imaimai17468/keyboard/scripts/assembly_viewer.html

# macjis 完成図

案 C · 81 キー · Choc V1 · 基板 v0（KiCad データ）· ケースは仮

完成 分解 基板

斜め 真上 横 奥

表 裏

ラベル

読み込み中…

## 表示する部品

ケース カバー キーキャップ スイッチ 基板 電池

「分解」で部品を上下に離して重なりを確認できます。「基板」は KiCad の設計データそのままの基板で、表と裏を切り替えられます。

## 仕上げ（確定）

キーキャップ

黒（Black Resin）、刻印は彫りのみ

基板

黒（JLCPCB のソルダーレジスト）

ケース

アルミ、ビーズブラスト + クリアアルマイト（銀）

上帯カバー

黒（Black Resin、キーキャップと同じ）、厚さ 2 mm

## 寸法

ケース外形

294.8 × 143.3 mm

ケース高さ

キー側 15.1 mm／上帯側 18.1 mm

キートップまで

16.1 mm（キー側）

基板

287.75 × 136.3 × 1.6 mm

キーキャップ

18.0 mm 角 × 5.8 mm

キーの沈み

2.7 mm

## 部品の数

スイッチ

85（81 キー）

ホットスワップソケット

85

ダイオード

81

M2 × 3 ナベ頭ネジ（基板）

7

M2 × 10 ネジ（カバー、底から）

3 ＋ インサート 3

中央の支え

3（上にカプトンテープ）

電源スイッチ

なし（fn＋esc 長押しで切る）

マイコン

XIAO nRF52840 Plus

電池

LiPo 250 mAh（EEMB 502030）

## まだ決まっていないこと

- なし（キーキャップの軸の太さは試作で 1.25 mm に決定）

## 購入リスト

2026-11-02 に全部注文済み。価格は 2026-10-20 の見積もり（実際の支払額は各店の注文履歴）。JLC は 1 回の注文が 50 件までなので 2 回に分けた

### JLC で作るもの

#### JLC3DP¥15,554

- キーキャップ 1u × 75（Black Resin） (https://jlc3dp.com/3d-printing-quote)¥12,8211 個 ¥171。軸 1.25 mm（試作で決定）。F・J は天板にポッチ付き 注文済み
- キーキャップ 大きいキー × 6 (https://jlc3dp.com/3d-printing-quote)¥1,065tab ¥173、control・右 shift ¥174、左 shift ¥177、return ¥179、space ¥188 注文済み
- 上帯カバー（Black Resin、厚さ 2 mm） (https://jlc3dp.com/3d-printing-quote)¥524長さ 290 mm 注文済み
- 送料（OCS Express、0.27 kg）¥1,1444〜6 営業日

#### JLCPCB$34.71 ≈ ¥5,311

- 基板 × 5 枚（2 層・1.6 mm・黒・鉛フリー HASL） (https://cart.jlcpcb.com/quote)$24.90287.75 × 136.3 mm。製造 3 日 注文済み
- 送料（UPS、0.81 kg）$9.812〜4 営業日

#### JLCCNC$126.22 ≈ ¥19,312

- アルミケース（6061、ビーズブラスト + アルマイト Natural・マット） (https://jlccnc.com/cnc-machining-quote)$116.41ネジ穴と底の段を直したデータで取り直した金額。最終価格は JLC の審査後に確定
- 送料（UPS、0.58 kg）$9.812〜4 営業日。M2 めねじ 7 か所は図面（case_drawing.pdf）、奥の面のアイコンと @imaimai17468 のレーザー刻印は DXF（case_marking.dxf、JLCCNC は DWG/DXF 必須）と図面 case_marking_drawing.pdf で指定。追加費用は審査で決まる 注文済み

### 電子部品

#### 遊舎工房¥12,683 + 送料

- Seeed Studio XIAO nRF52840 Plus (https://shop.yushakobo.jp/products/10946)¥2,200 × 1無線マイコン。予備が欲しければもう 1 個（壊したときの作り直しが早い） 購入済み
- Kailh Ambients Silent Choc V1 Nocturnal 20g（35 個入り） (https://shop.yushakobo.jp/collections/choc-v1/products/ambients-silent-choc-switches-20g-linear-nocturnal)¥5,390 × 2スイッチ 85 個 + 予備。試作用に買った 1 袋と合わせて 105 個 注文済み
- Kailh Switch Socket（10 個入り） (https://shop.yushakobo.jp/products/a01ps)¥187 × 9ホットスワップソケット 85 個 + 予備。種類は「Choc（CPG135001S30）」を選ぶ 注文済み
- ダイオード - SMDタイプ（100 個入り） (https://shop.yushakobo.jp/products/a0800di-02-100)¥2201N4148W × 81。手ではんだ付け 注文済み

#### Amazon¥1,199

- EEMB 3.7V 502030 250mAh リポバッテリー (https://www.amazon.co.jp/dp/B08FD3V6TF)¥1,199電池。コネクタは切って線を基板の穴に直接はんだ付け（赤 = 1 番ピン +） 注文済み

### ネジ・組み立て部品

#### Amazon¥4,995

- ステンレス/SSブラック ナベ小ねじ M2×3（10 本） (https://www.amazon.co.jp/dp/B0B2ZM6G8H)¥680基板をケースに留める × 7。黒いネジで基板・キーキャップの黒になじむ。めねじは有効 1.5 mm なので 3 mm（基板 1.6 + 1.4） 注文済み
- ステンレス ナベ頭 小ねじ M2×10（10 本） (https://www.amazon.co.jp/dp/B079WL3BDD)¥600底から上帯カバーを留める × 3 注文済み
- uxcell インサートナット M2 3×3 mm（100 個） (https://www.amazon.co.jp/dp/B0CTTLJL6S)¥852カバーの柱 × 3。樹脂のカバーは熱で溶けないので接着で入れる 注文済み
- セメダイン ハイスーパー5（6 g） (https://www.amazon.co.jp/dp/B003SJVNQ0)¥427インサートの接着用（5 分硬化エポキシ） 注文済み
- ゴム足 φ10 × 高さ 4 mm（16 個） (https://www.amazon.co.jp/dp/B07V8RDJTH)¥598手前の足 × 2 注文済み
- 3M クッションゴム CS-01 φ7.9 × 2.2 mm（22 粒） (https://www.amazon.co.jp/dp/B00V5MQQ5A)¥344奥の足 × 2。奥が 1.2 mm 高くなり、手前に少し傾く 注文済み
- DanYun カプトンテープ 15 mm × 33 m (https://www.amazon.co.jp/dp/B08JYBJ43B)¥645電池の下の絶縁と、中央の支え柱の上に貼る 注文済み
- 3M スコッチ 強力両面テープ 15 mm × 10 m（PSD-15R） (https://www.amazon.co.jp/dp/B09V358S45)¥849電池をケースの底に貼る 注文済み

### 合計（2026-10-20 の見積もり）

JLC（3 社、送料込み）

¥40,177

遊舎工房（送料込み）

¥18,623

Amazon

¥6,194

合計

¥64,994

ドルは 1 ドル ≈ 153 円（JLC3DP の円表示から逆算）で換算。購入済みの XIAO（¥2,200）は含まない。JLC の荷物は輸入の消費税と通関手数料が別にかかることがある（数千円程度）。JLC の画面に出ているクーポン（$20〜$50 引き）が使えればその分安くなる。
