imaimai17468/keyboard/pcb/macjis.kicad_pcb

## KiCad design pcb/macjis.kicad_pcb (2026-10-20)

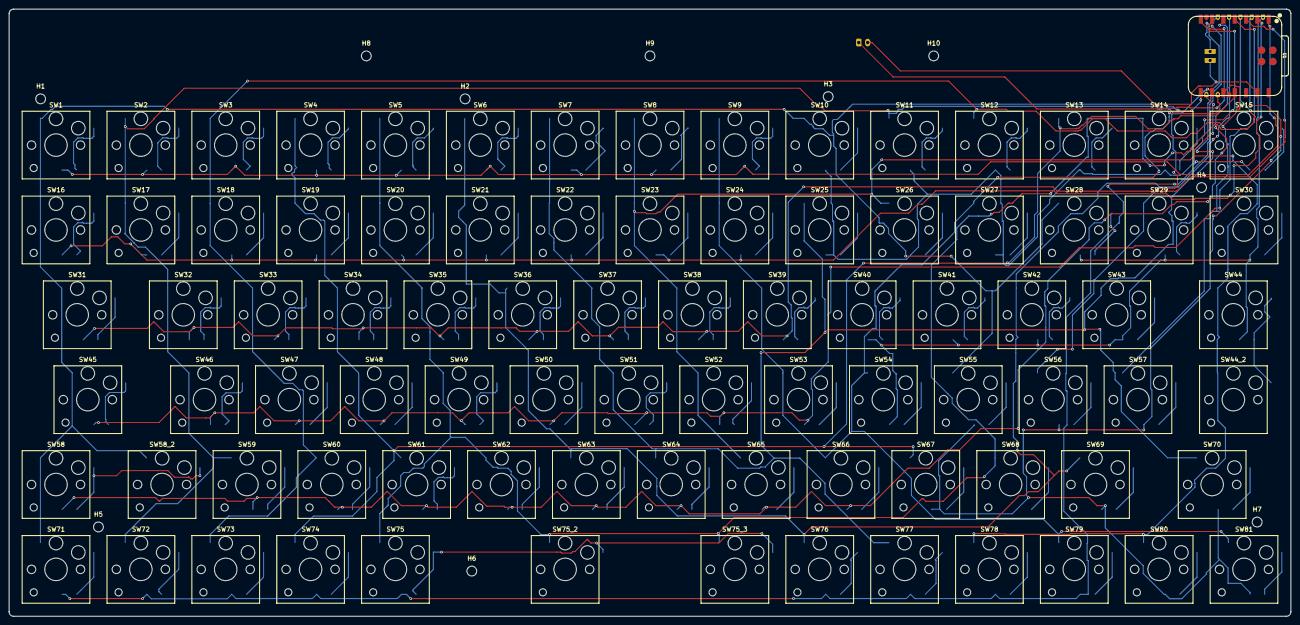
[picture p1: board macjis.kicad_pcb from above]

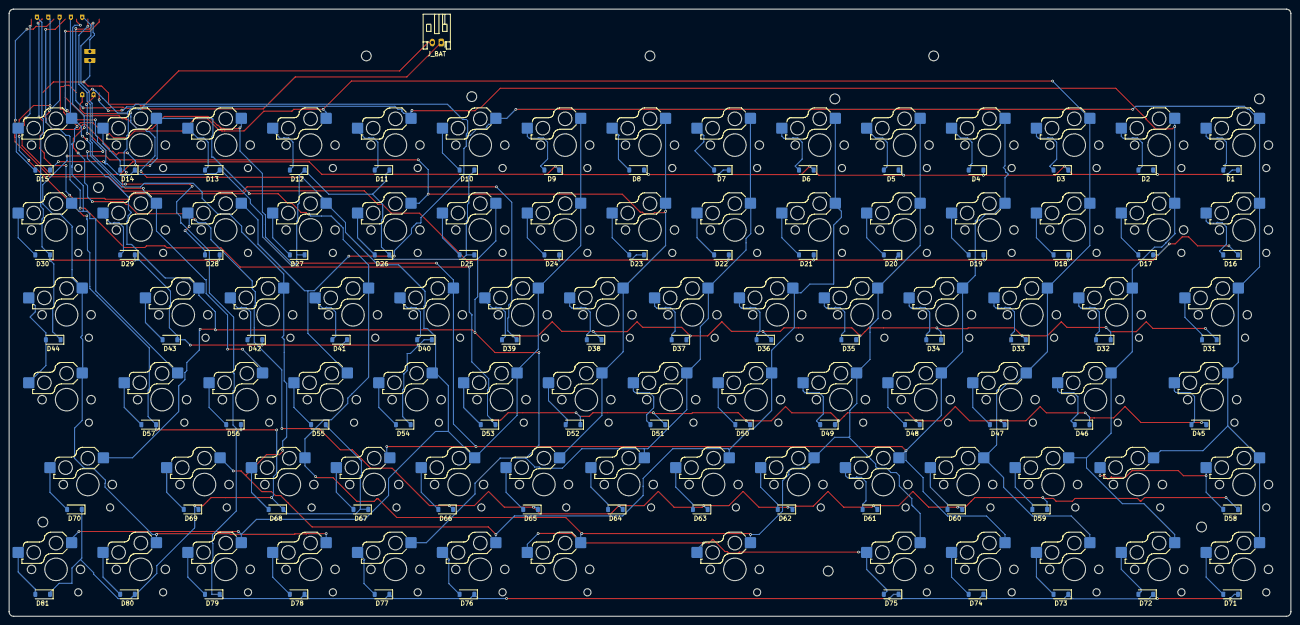
[picture p2: board macjis.kicad_pcb from below]

Board: 2 copper layers, 287.8 x 136.3 mm, 178 parts (82 on the bottom side), 101 nets.

Parts:
D1, D2, D3, D4, D5, D6, D7, D8, D9, D10, D11, D12, D13, D14, D15, D16, D17, D18, D19, D20, D21, D22, D23, D24, D25, D26, D27, D28, D29, D30, D31, D32, D33, D34, D35, D36, D37, D38, D39, D40, D41, D42, D43, D44, D45, D46, D47, D48, D49, D50, D51, D52, D53, D54, D55, D56, D57, D58, D59, D60, D61, D62, D63, D64, D65, D66, D67, D68, D69, D70, D71, D72, D73, D74, D75, D76, D77, D78, D79, D80, D81: D_SOD-123
H1, H2, H3, H4, H5, H6, H7, H8, H9, H10: MountingHole_2.2mm_M2_ISO14580
J_BAT: JST_PH_S2B-PH-K_1x02_P2.00mm_Horizontal
SW1, SW2, SW3, SW4, SW5, SW6, SW7, SW8, SW9, SW10, SW11, SW12, SW13, SW14, SW15, SW16, SW17, SW18, SW19, SW20, SW21, SW22, SW23, SW24, SW25, SW26, SW27, SW28, SW29, SW30, SW31, SW32, SW33, SW34, SW35, SW36, SW37, SW38, SW39, SW40, SW41, SW42, SW43, SW44, SW44_2, SW45, SW46, SW47, SW48, SW49, SW50, SW51, SW52, SW53, SW54, SW55, SW56, SW57, SW58, SW58_2, SW59, SW60, SW61, SW62, SW63, SW64, SW65, SW66, SW67, SW68, SW69, SW70, SW71, SW72, SW73, SW74, SW75, SW75_2, SW75_3, SW76, SW77, SW78, SW79, SW80, SW81: SW_Hotswap_Kailh_Choc_V1V2
U1: XIAO-nRF52840-Plus-SMD

Connections:
BAT+: J_BAT.1, U1.28
COL0: SW1.1, SW10.1, SW16.1, SW28.1, SW31.1, SW45.1, SW55.1, SW58.1, SW58_2.1, SW71.1, U1.8
COL1: SW2.1, SW11.1, SW17.1, SW29.1, SW32.1, SW46.1, SW56.1, SW59.1, SW72.1, U1.9
COL2: SW3.1, SW12.1, SW18.1, SW30.1, SW33.1, SW47.1, SW57.1, SW60.1, SW73.1, U1.10
COL3: SW4.1, SW13.1, SW19.1, SW34.1, SW40.1, SW48.1, SW61.1, SW67.1, SW74.1, U1.11
COL4: SW5.1, SW14.1, SW20.1, SW35.1, SW41.1, SW49.1, SW62.1, SW68.1, SW75.1, SW75_2.1, SW75_3.1, U1.17
COL5: SW6.1, SW15.1, SW21.1, SW36.1, SW42.1, SW50.1, SW63.1, SW69.1, SW76.1, U1.18
COL6: SW7.1, SW22.1, SW25.1, SW37.1, SW43.1, SW51.1, SW64.1, SW70.1, SW77.1, U1.19
COL7: SW8.1, SW23.1, SW26.1, SW38.1, SW44.1, SW44_2.1, SW52.1, SW65.1, SW78.1, SW80.1, U1.21
COL8: SW9.1, SW24.1, SW27.1, SW39.1, SW53.1, SW54.1, SW66.1, SW79.1, SW81.1, U1.22
GND: J_BAT.2, U1.13, U1.29
ROW0: D1.1, D2.1, D3.1, D4.1, D5.1, D6.1, D7.1, D8.1, D9.1, U1.1
ROW1: D16.1, D17.1, D18.1, D19.1, D20.1, D21.1, D22.1, D23.1, D24.1, U1.2
ROW2: D31.1, D32.1, D33.1, D34.1, D35.1, D36.1, D37.1, D38.1, D39.1, U1.3
ROW3: D45.1, D46.1, D47.1, D48.1, D49.1, D50.1, D51.1, D52.1, D53.1, U1.4
ROW4: D58.1, D59.1, D60.1, D61.1, D62.1, D63.1, D64.1, D65.1, D66.1, U1.5
ROW5: D71.1, D72.1, D73.1, D74.1, D75.1, D76.1, D77.1, D78.1, D79.1, U1.6
ROW6: D10.1, D11.1, D12.1, D13.1, D14.1, D15.1, D25.1, D26.1, D27.1, U1.7
ROW7: D28.1, D29.1, D30.1, D40.1, D41.1, D42.1, D43.1, D44.1, D54.1, U1.15
ROW8: D55.1, D56.1, D57.1, D67.1, D68.1, D69.1, D70.1, D80.1, D81.1, U1.16
SW1_D: D1.2, SW1.2
SW2_D: D2.2, SW2.2
SW3_D: D3.2, SW3.2
SW4_D: D4.2, SW4.2
SW5_D: D5.2, SW5.2
SW6_D: D6.2, SW6.2
SW7_D: D7.2, SW7.2
SW8_D: D8.2, SW8.2
SW9_D: D9.2, SW9.2
SW10_D: D10.2, SW10.2
SW11_D: D11.2, SW11.2
SW12_D: D12.2, SW12.2
SW13_D: D13.2, SW13.2
SW14_D: D14.2, SW14.2
SW15_D: D15.2, SW15.2
SW16_D: D16.2, SW16.2
SW17_D: D17.2, SW17.2
SW18_D: D18.2, SW18.2
SW19_D: D19.2, SW19.2
SW20_D: D20.2, SW20.2
SW21_D: D21.2, SW21.2
SW22_D: D22.2, SW22.2
SW23_D: D23.2, SW23.2
SW24_D: D24.2, SW24.2
SW25_D: D25.2, SW25.2
SW26_D: D26.2, SW26.2
SW27_D: D27.2, SW27.2
SW28_D: D28.2, SW28.2
SW29_D: D29.2, SW29.2
SW30_D: D30.2, SW30.2
SW31_D: D31.2, SW31.2
SW32_D: D32.2, SW32.2
SW33_D: D33.2, SW33.2
SW34_D: D34.2, SW34.2
SW35_D: D35.2, SW35.2
SW36_D: D36.2, SW36.2
SW37_D: D37.2, SW37.2
SW38_D: D38.2, SW38.2
SW39_D: D39.2, SW39.2
SW40_D: D40.2, SW40.2
SW41_D: D41.2, SW41.2
SW42_D: D42.2, SW42.2
SW43_D: D43.2, SW43.2
SW44_D: D44.2, SW44.2, SW44_2.2
SW45_D: D45.2, SW45.2
SW46_D: D46.2, SW46.2
SW47_D: D47.2, SW47.2
SW48_D: D48.2, SW48.2
SW49_D: D49.2, SW49.2
SW50_D: D50.2, SW50.2
SW51_D: D51.2, SW51.2
SW52_D: D52.2, SW52.2
SW53_D: D53.2, SW53.2
SW54_D: D54.2, SW54.2
SW55_D: D55.2, SW55.2
SW56_D: D56.2, SW56.2
SW57_D: D57.2, SW57.2
SW58_D: D58.2, SW58.2, SW58_2.2
SW59_D: D59.2, SW59.2
SW60_D: D60.2, SW60.2
SW61_D: D61.2, SW61.2
SW62_D: D62.2, SW62.2
SW63_D: D63.2, SW63.2
SW64_D: D64.2, SW64.2
SW65_D: D65.2, SW65.2
SW66_D: D66.2, SW66.2
SW67_D: D67.2, SW67.2
SW68_D: D68.2, SW68.2
SW69_D: D69.2, SW69.2
SW70_D: D70.2, SW70.2
SW71_D: D71.2, SW71.2
SW72_D: D72.2, SW72.2
SW73_D: D73.2, SW73.2
SW74_D: D74.2, SW74.2
SW75_D: D75.2, SW75.2, SW75_2.2, SW75_3.2
SW76_D: D76.2, SW76.2
SW77_D: D77.2, SW77.2
SW78_D: D78.2, SW78.2
SW79_D: D79.2, SW79.2
SW80_D: D80.2, SW80.2
SW81_D: D81.2, SW81.2
