imaimai17468/keyboard/(commit log)

2026-10-19 Add parts spec for keycaps, PCB colors, and case
2026-10-19 Add keyboard design pipeline: layout, PCB, firmware, keycaps, case
    - Layout C (MacBook-style JIS, 81 keys) from KLE JSON to keys.json
    - 9x9 matrix on XIAO nRF52840 Plus, KiCad board generation and
    Freerouting autoroute with DRC and JLCPCB gerber export
    - Long keys supported by multiple parallel Choc V1 switches
    - ZMK v0.3 shield with soft off (fn+esc) and rgbled-widget status LED
    - build123d keycap prototypes and aluminium tray case with resin cover
    - 3D assembly viewer generated from the board and case models
    Claude-Session: https://claude.ai/code/session_01M64MEgyXCv4yyqteTiebrm
2026-10-20 Widen battery cavity for 20 mm wide LiPo; add hardware BOM
    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
2026-10-20 Update viewer BOM
    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
2026-10-20 Add purchase list with store links; match feet and inserts to buyable parts
    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
2026-10-20 Cover: Black Resin, 2 mm thick
    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
2026-10-20 Case DFM per JLCCNC notes: 2.5 mm blind taps, USB opening R1, tap drawing PDF
    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
2026-10-20 Move floor step clear of strip screw bosses so the cutter can pass
    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
2026-10-20 XIAO extra pads: plated holes for soldering from the back; reroute
    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
2026-10-20 Viewer: translucent black mask over traces, HASL pads, close zoom in board mode
    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
2026-10-20 Space cover screws evenly between the back feet; move battery connector
    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
2026-10-20 Laser-mark icon and handle on the back face; marking drawing for JLCCNC
    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
2026-10-28 Keycap stems 1.25 mm, chosen from the fit prototype
    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
2026-10-28 Spec: Space works with 2 or 3 switches (prototype result)
    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
2026-10-28 Spec: prototype blockers resolved; 1:1 print PDFs for the PCB fit check
    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
2026-11-02 Homing bars on F and J keycaps
2026-11-02 Record orders: JLC (PCB, case, keycaps), Yushakobo and Amazon parts
2026-11-02 Generate the case laser-marking DXF in gen_assembly
    JLCCNC requires DWG/DXF for laser marking. The DXF used for the order was
    made by a one-off script; gen_assembly now writes the same file (back face
    outline and marking at 1:1) next to case_marking.svg.
2026-11-03 Add AGENTS.md with PCB parts selection rules
    JLCPCB Basic Parts only for PCBA, hand-soldered parts from Akizuki,
    small parts left to PCBA, fewer part types. CLAUDE.md imports it.
